dangdangduong2k2/Temperature_warning_ms51fb9ae/PCB/note.txt

them GND NTC
sai chiều jack nguồn
trở 10R pwm
them tụ song song C27 100pF
