dangdangduong2k2/Temperature_warning_ms51fb9ae/PCB/GiaCong/BOM/2024-10-02 BOM Project name.xlsx

Code | Code_sub1 | Comment | Description | Designator | Footprint | LibRef | Layer | Quantity
 |  | PJ-313 3.5mm |  | JACK1 | PJ-320A-PCB | PJ-313 3.5mm | Top | 1
1024-082 |  | 680R | Resistor SMD 0805 | R8 | RES-SMD-0805 | Res 680R 0805 | Top | 1
1024-086 |  | 1k | Resistor SMD 0805 | R21 | RES-SMD-0805 | Res 1k 0805 | Top | 1
1024-094 |  | 2.2k | Resistor SMD 0805 | R7, R11, R17, R23, R25, R26, R35 | RES-SMD-0805 | Res 2.2K 0805 | Top | 7
1024-103 |  | 4.7K | Resistor SMD 0805 | R22, R24 | RES-SMD-0805 | Res 4.7k 0805 | Top | 2
1024-111 |  | 10K | Resistor SMD 0805 | R1, R2, R6, R9, R10, R14, R15, R16, R18, R27, R28, R29, R30, R31, R32, R33, R34, R36, R37, R38, R39 | RES-SMD-0805 | Res 10k 0805 | Top | 21
1025-063 |  | 100R | Resistor SMD 0805 | R3, R4, R12, R13, R19, R20 | RES-SMD-0805 | Res 100R 0805 | Top | 6
1032-005 |  | 0.22R/1W | Resistor SMD 2512 1W | R5 | RES-SMD-2512 | Res 0.22R 2512 1W | Top | 1
1402-103 |  | 47uF/25V | Polarized Capacitor (Axial) 47uF 25V | C3, C4, C12, C13, C16, C17 | C5mm | Cap Pol 47uF/25V | Top | 6
1402-225 |  | 100uF/35V | Polarized Capacitor (Axial) 100uF 35V | C1, C10, C32 | C_6.3x12 | Cap Pol 100uF/35V | Top | 3
1402-228 |  | 220uF/35V | Polarized Capacitor (Axial) 220uF 35V | C30 | C8X12mm | Cap Pol 220uF/35V | Top | 1
1402-231 |  | 470uF/35V | Polarized Capacitor (Axial) 470uF 35V | C8 | C10mm | Cap Pol 470uF/35V | Top | 1
1436-100 |  | 10uF/25V | Cap SMD 0805 10uF | C21 | C_0805_SMD | Cap 0805 10uF 25V | Top | 1
1438-034 |  | 47pF/50V | Capacitor SMD 0805 | C26, C28 | C_0805_SMD | Cap 0805 47pF 50V | Top | 2
1438-056 |  | 470pF/50V | Cap SMD 0805 470pF 50V | C7 | C_0805_SMD | Cap 0805 470pF 50V | Top | 1
1438-080 |  | 104 | Cap SMD 0805 104-100nF-0.1uF 50V | C2, C5, C6, C9, C11, C14, C15, C18, C19, C20, C22, C27, C29, C31, C33 | C_0805_SMD | Cap 0805 104 100nF | Top | 15
1438-092 |  | 1uF/50V | Cap SMD 0805 105 - 1uF 50V | C23, C24 | C_0805_SMD | Cap 0805 1uF 50V | Top | 2
1523-012 |  | 4.7uH | INDUCTOR, POWER, SMD | L2 | CD53 | CD53 5852-220 22uH 1.5A | Top | 1
1526-001 |  | 220uH | INDUCTOR SMD | L1 | CDRH74 | CD74 7345-221 220uH | Top | 1
1701-070 |  | S8050 | J3Y-NPN SMD Transistor SOT23 | Q1, Q2 | SOT23_N NXP | S8050 SOT-23 | Top | 2
1901-0360 |  | AO3400 | N-Channel 1.4W, Vds = 30V, Vgs = +-12V, Id = 4.9A | Q3 | SOT23_N NXP | AO3400 | Top | 1
2001-012 |  | LL4148 | 0.2A, 100V, SOD80 | D7, D8 | SOD80C_MFG | LL4148 | Top | 2
2005-008 |  | SS34 | Surface-Mount Schottky Barrier Rectifier | D1, D3, D4, D6, D9, D10 | D_SMA | SS34-SMA | Top | 6
2006-010 |  | SMAJ5.0A | SMAJ5.0A Series 400 W 5 V Surface Mount Uni-Directional TVS Diode - DO-214AC | D2 | D_SMA | TVS SMAJ5_0A-E3-61-DO241AC | Top | 1
2401-001 |  | Relay 20A/5V | Relay SPDT,20A - 5VDC 5 Pin SONGLE SRA | RL1 | Relay 5 pin SRA AL | Relay 5V 5 Pin 20A SRA | Top | 1
3509-001 |  | XH2.54 2P | Header XH2.54mm P | P1, P2, P6, P7, P10, P11, P13 | XH2.54_2P | XH2.54 HEADER 2 PIN | Top | 7
3509-002 |  | XH2.54 3P | XH-T-3 HEADER 3 Pin XH2.54 | P8 | XH2.54_3P | XH2.54 HEADER 3 Pin | Top | 1
3509-003 |  | XH2.54 4P | XH-T-4 HEADER 4 Pin XH2.54 | P14, P15 | XH2.54_4P | XH2.54 HEADER 4 Pin, Header LCD I2C | Top | 2
3520-013 |  | KF128 2P | Header, 2-Pin, Medium KF128 2P-5.08mm | P3, P5, P9 | KF128 5.08 2P | KF128-5.08-2P-5.08mm | Top | 3
3520-014 |  | KF128 3P | Header, 3-Pin, Medium KF128 3P-5.08mm | P4 | KF128 5.08 3P | KF128-5.08-3P-5.08mm | Top | 1
3610-003 |  | BT4 | Switch button 4 pin 6x6x5mm DIP | SW1, SW2 | SW4 | SW4 DIP 6x6x5mm | Top | 2
5015-078 |  | MC34063ADR | MC3x063A 1.5-A Peak Boost/Buck/Inverting Switching Regulators | UN1 | SO_8 | MC34063ADR | Top | 1
7006-050 |  | JQ6500 |  | U2 | JQ6500 md | Module JQ6500 | Top | 1
7201-019 |  | MS51FB9AE | MS51FB9AE, ROM 16KB, RAM 256B + 1KB, SPROM 128B, 1T 8051-based CMOS up to 24Mhz | U1 | SOG65_20 | MS51FB9AE | Top | 1
8600-017 |  | LED RED | LED 0805 SMD RED | LED1, PW | LED 0805 Red | LED 0805 RED | Top | 2
8600-019 |  | LED BLUE | LED 0805 SMD BLUE | LED2, LED3 | LED 0805 Blue | LED 0805 BLUE | Top | 2
N/A |  | SMAJ24A | SMAJ Series 400W Surface Mount Uni-Directional TVS Diode - DO-214AC | D5 | DO_241AC_SMA_MFG | TVS SMAJ24A-DO241AC | Top | 1
