dangdangduong2k2/Temperature_warning_ms51fb9ae/(list of files, cad)

Other CAD files:
Code/temp_board/Objects/main.obj
Code/temp_board_v2/Objects/main.obj
