dangdangduong2k2/Temperature_warning_ms51fb9ae/PCB/GiaCong/Local/Schematic_2024-10-02_Project name.PDF

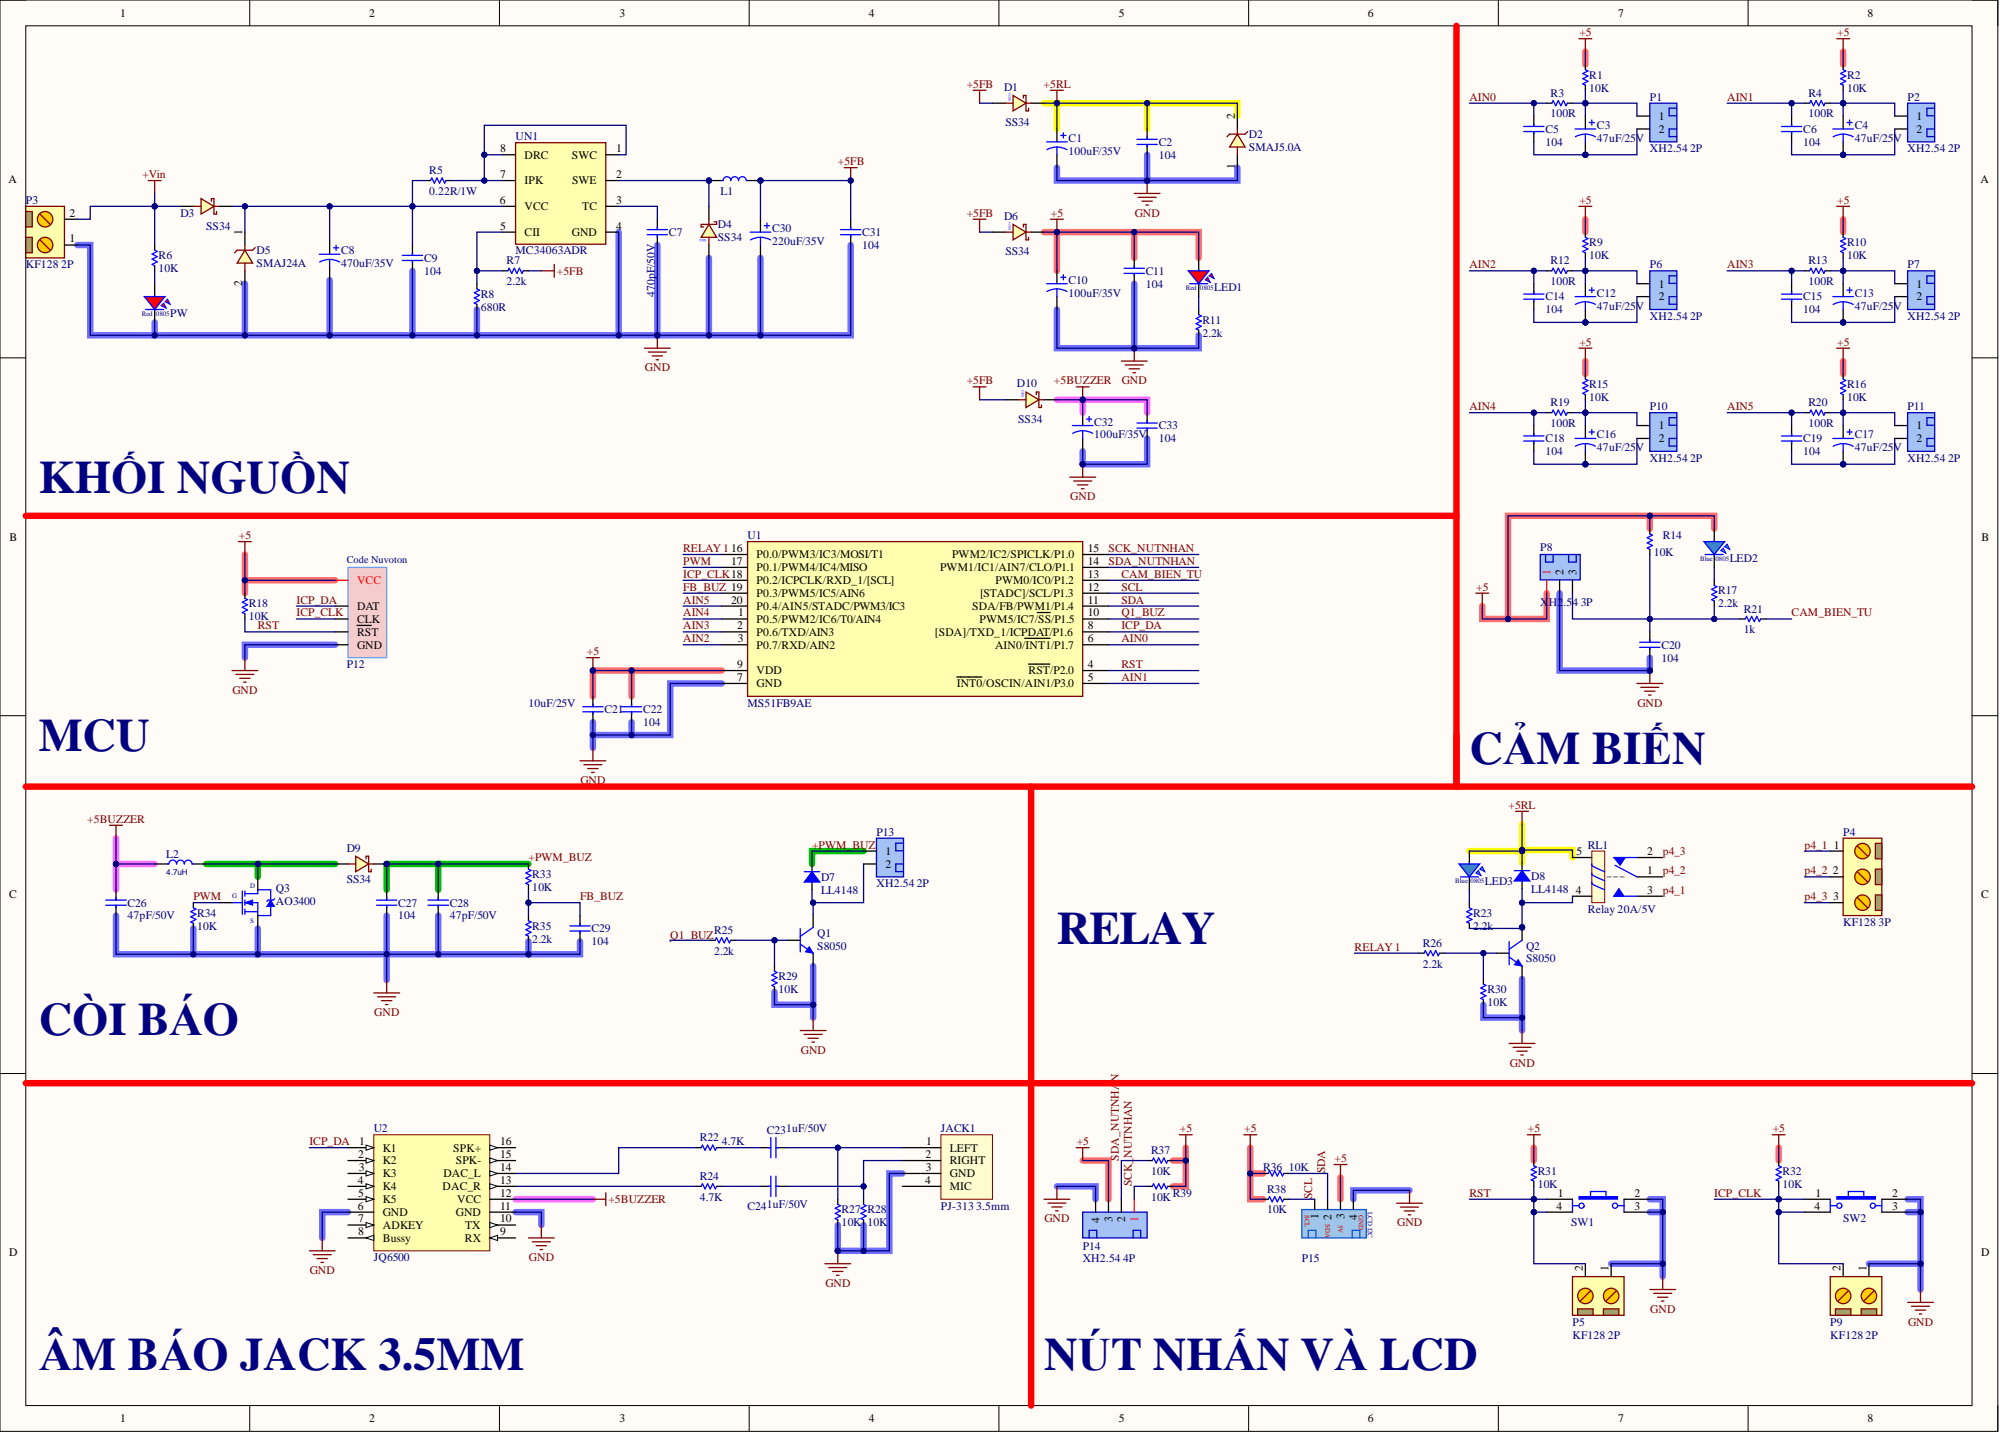
[picture p1: page 1]

K3 3 | GND 3
