dangdangduong2k2/Temperature_warning_ms51fb9ae/PCB/GiaCong/TEM_ALARM _CIRCUIT.PDF

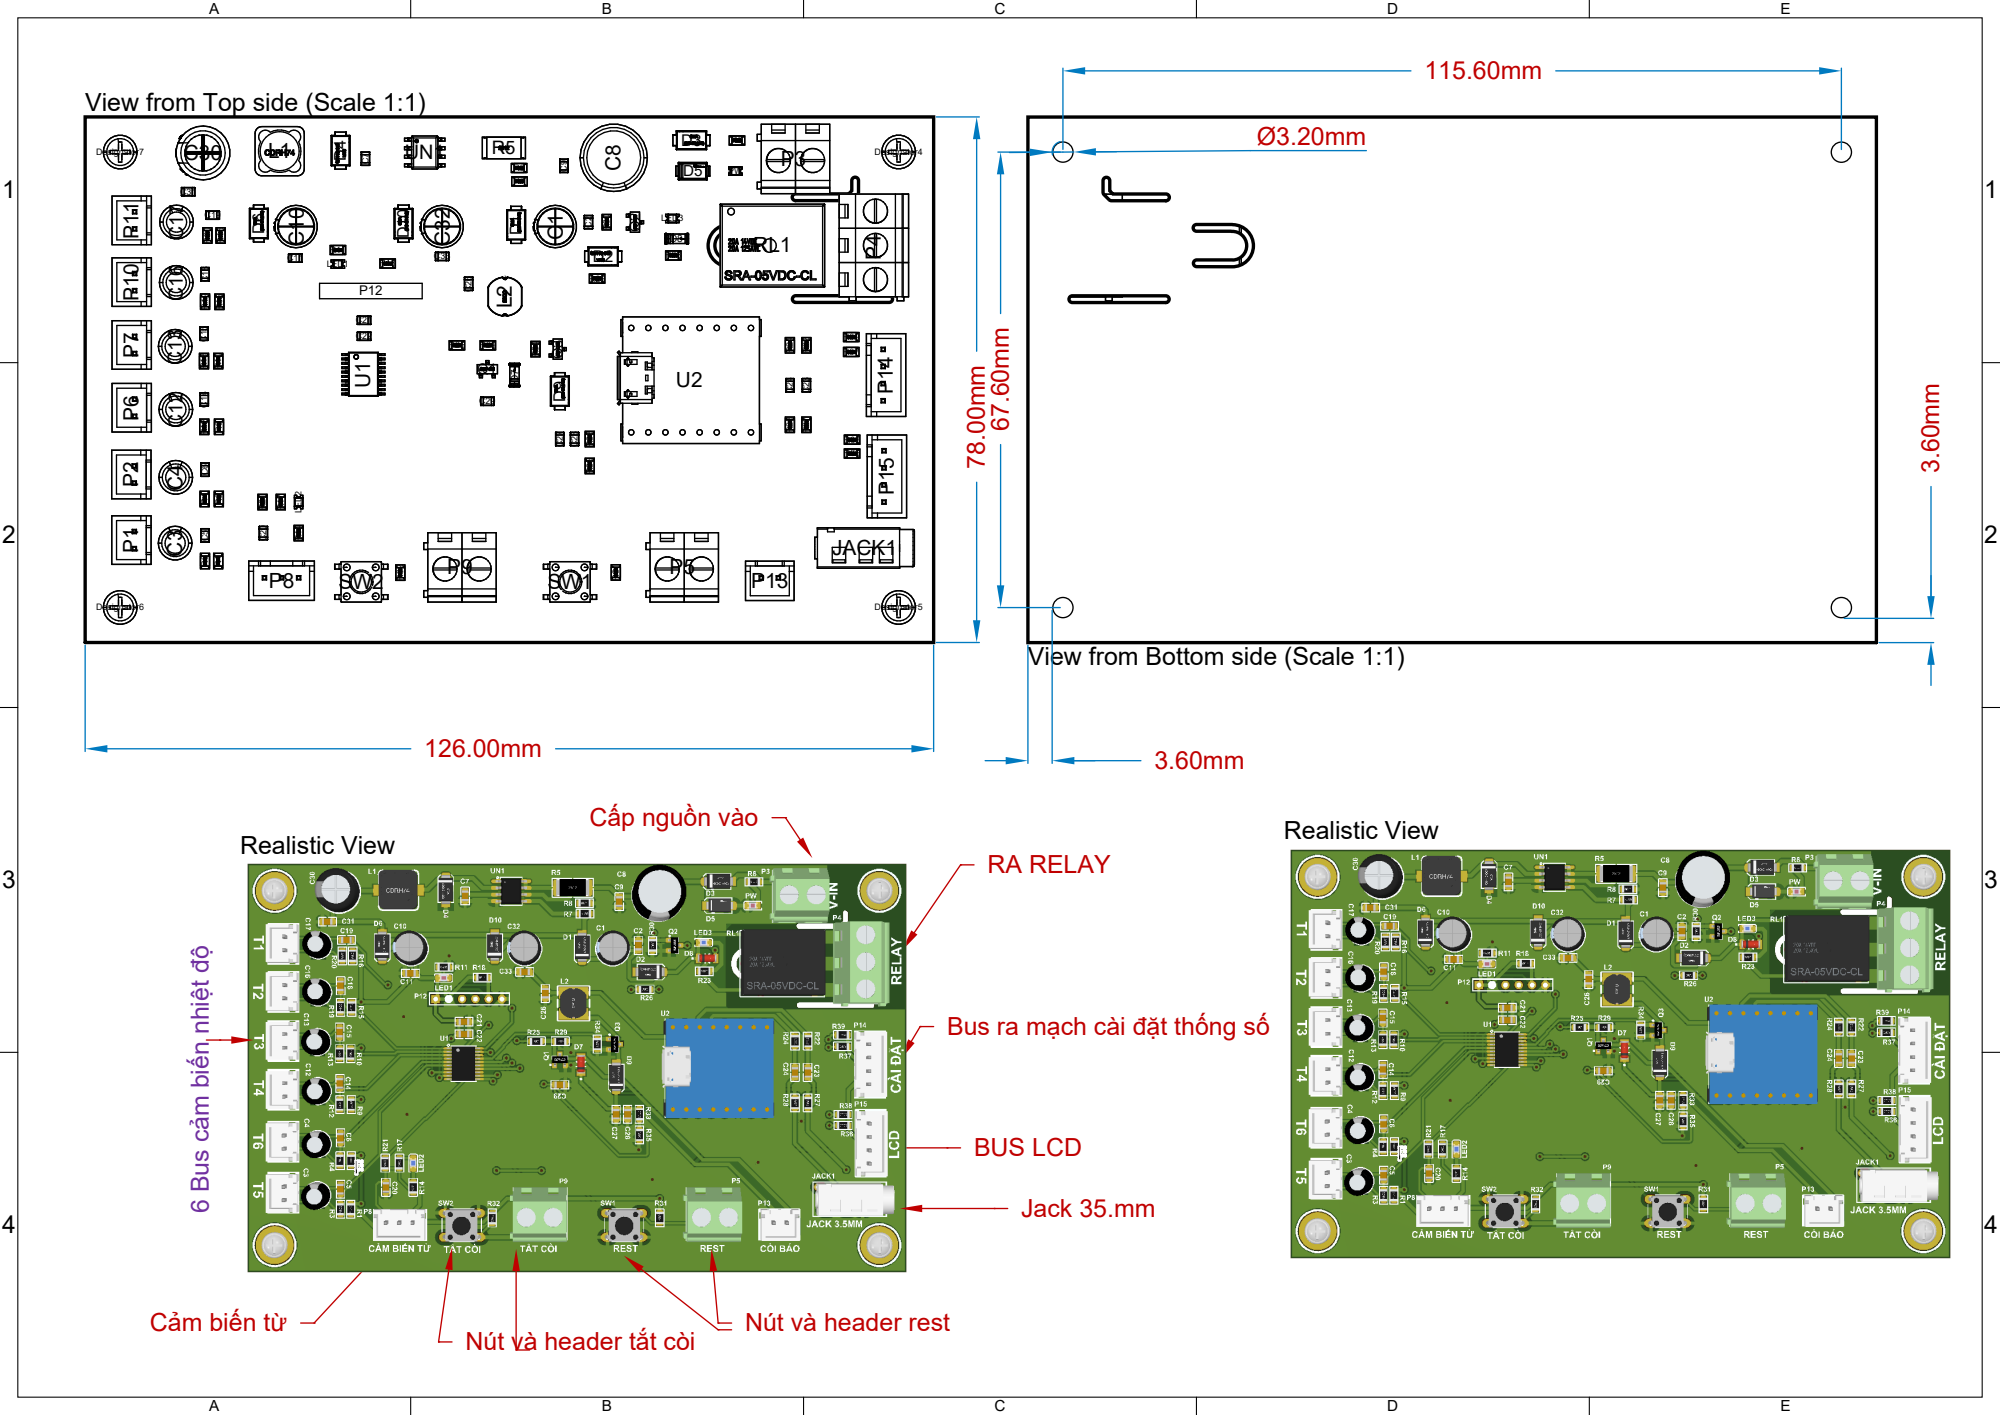
[picture p2: page 1]

View from Top side (Scale 1:1)

View from Bottom side (Scale 1:1)

6 Bus cảm biến nhiệt độ

Bus ra mạch cài đặt thống số

Nút và header rest

Nút và header tắt còi
