dangdangduong2k2/Temperature_warning_ms51fb9ae/PCB/GiaCong/Local/PCB_Position_2024-10-02_Project name.PDF

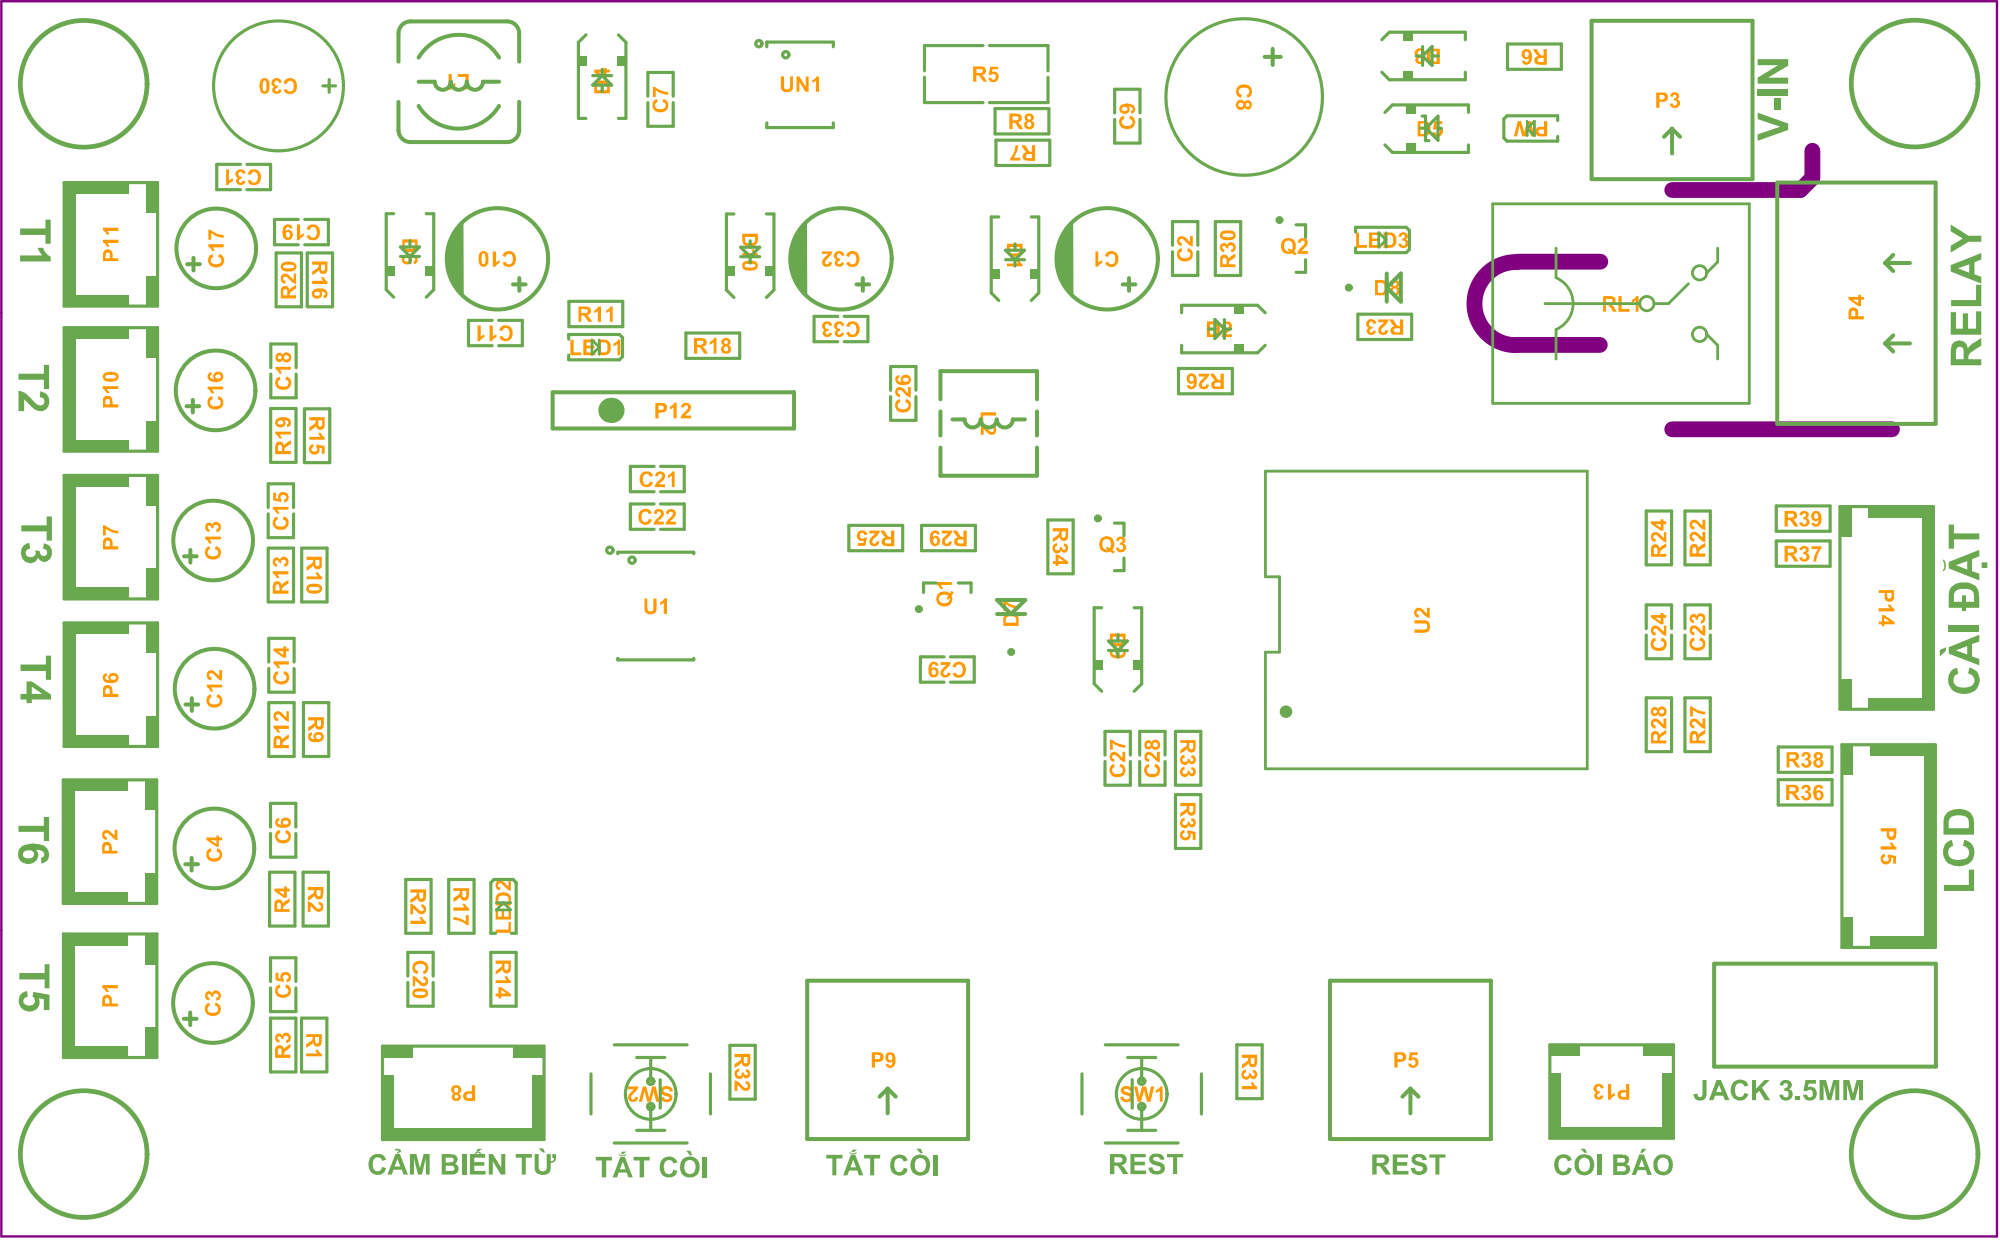
[picture p3: page 1]

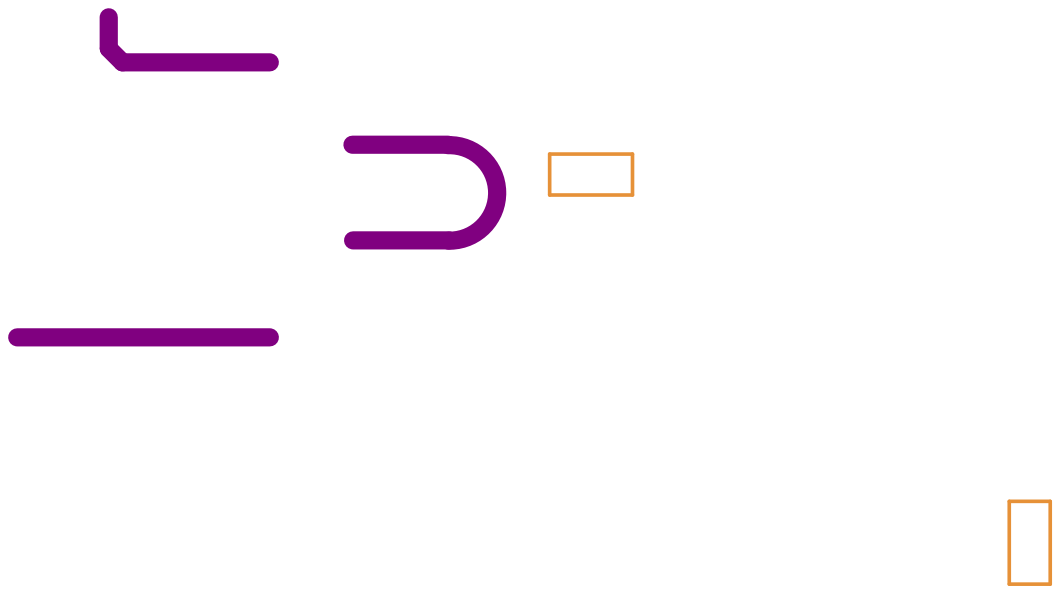
[picture p4: page 2]
