dangdangduong2k2/Temperature_warning_ms51fb9ae/(list of files, drawings)

Other design files:
PCB/History/schematic.~(9).SchDoc/schematic.~(9).SchDoc
PCB/mcu.SchDoc
PCB/nguon.SchDoc
PCB/panel 2x4.PcbDoc
PCB/Project name.PrjPCB
PCB/schematic.SchDoc
