dangdangduong2k2/Temperature_warning_ms51fb9ae/Code/temp_board/main.h

#include "N76E003.h"
#include "delay.c"
#include "WDT.c"
#include "Function_System.c"
#include "HIRC.c"
#include "Config_GPIO.c"
#include "ADC.c"
#include "I2C_LCD.h"
#include "I2C_SW.h"
#include "TM1650.h"
#include "NTC_10K.c"
#include "Data_Flash_Point.c"
